IR2110/VVVF-nano/Kicad/VVVF_nano_v2/VVVF_nano_rev.2.png

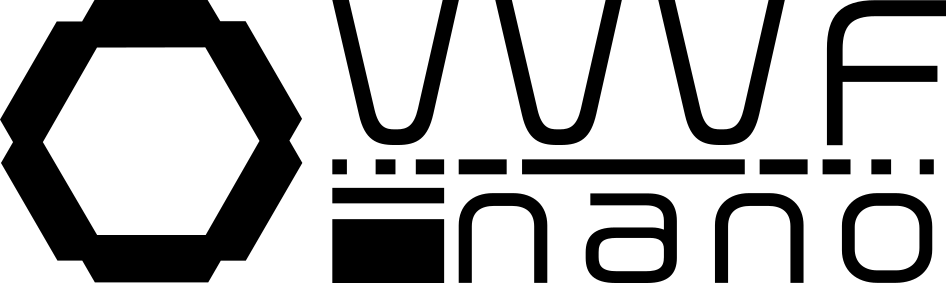
Kicad/VVVF_nano_v2/VVVF_nano_rev.2.png
