IR2110/VVVF-nano/Kicad/VVVF_nano_v2/PTV09A_2015U_B103/PTV09A-2015U-B103.step

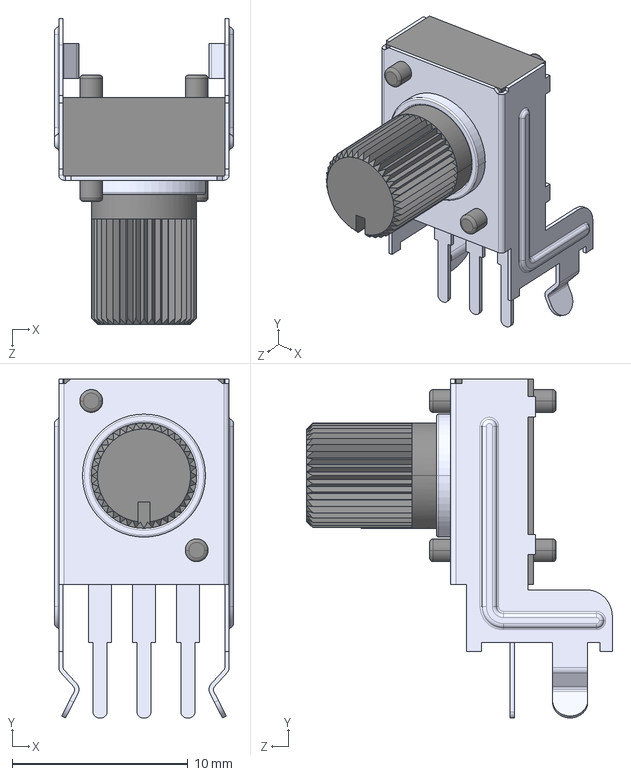
[picture p9: CAD file, 2026-10-23]
Kicad/VVVF_nano_v2/PTV09A_2015U_B103/PTV09A-2015U-B103.step
10.2 x 19.3 x 17.4 mm
