IR2110/VVVF-nano/(commit log)

2026-10-24 余白そろえた
2026-10-24 フォントをSource Han Sans→源暎ゴシックPに変更
2026-11-01 UUID対応
2026-11-02 レベ選択
2026-11-02 併結修正
2026-11-02 表示ちょいしゅうせい
2026-11-02 ソースコードうp
2026-11-03 説明書うp
    ごめんなさい
